lo1ol/DarkroomStopwatch/(commit log)

2024-12-13 Add short alarm for pre notify
    [Beeper.cpp, Beeper.h, main.cpp]
2024-12-13 Force start with Timer set on wake up after sleep
